Rulodonte/SISTEMA-DE-CONTROL-AMBIENTAL-MULTICAMARA/README.md

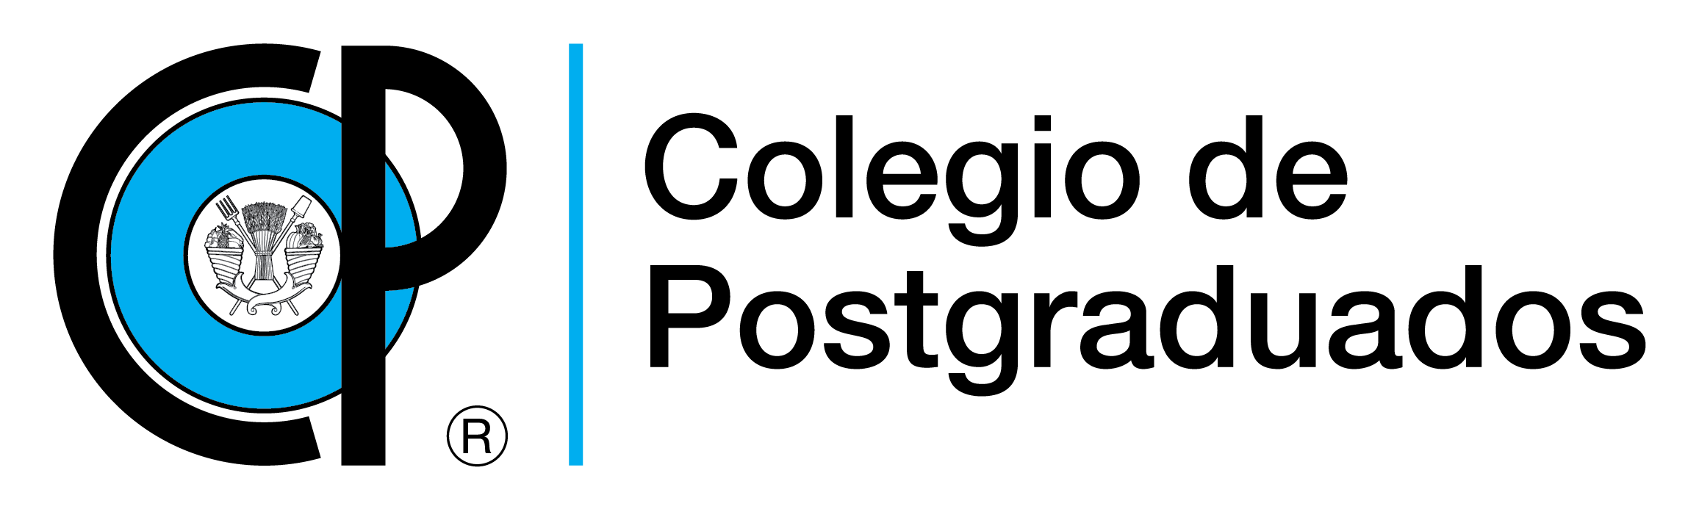
[picture p1: Imagenes_README/Logo_COLPOS.png]
Agregamos banner principal

<br><br><br><br>
# SISTEMA DE CONTROL AMBIENTAL MULTICAMARA

## Resumen
En este apartado se presentarán los anexos correspondientes al artículo titulado "Desarrollo y Evaluación de un Sistema de Control Ambiental Multicámara". 
Los anexos contienen información detallada sobre los materiales utilizados en la construcción del sistema y los componentes de los subsistemas de entrada, 
control y salida. Además, se proporciona una visión general de cómo se diseñó el sistema y se incluyen diagramas que ilustran la disposición de los 
dispositivos y el flujo de la aplicación de control.

## Contenido
- [Descripción general del sistema](#Descripción-general-del-sistema)
- [Hardware](#Hardware)
  - [Estructura](#Estructura)
  - [Dispositivos de entrada](#Dispositivos-de-entrada)
  - [Dispositivos de salida](#Dispositivos-de-salida)
  - [Dispositivos de control](#Dispositivos-de-control)
- [Software](#Software)
  - [Aplicación para Windows](#Aplicación-para-Windows)
  - [Código de control para Arduino](#Condigo-de-control-para-Arduiono)
- [Lista de materiales](#Lista-de-materiales)
- [Anexo](#Anexo)

## Descripción general del sistema
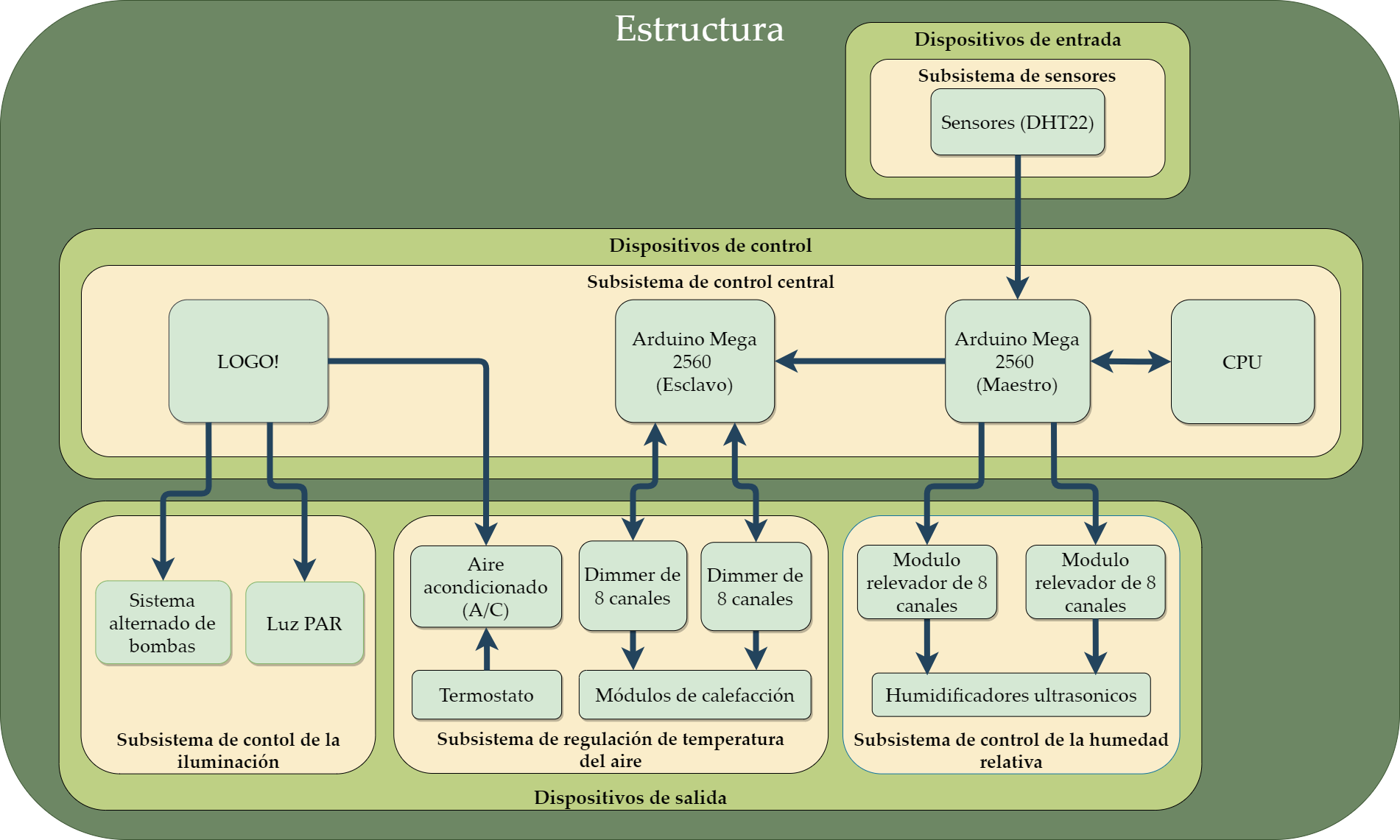
[picture p2: Imagenes_README/DiagramaHardware.png]
Agregamos diagrama de hardware

**Figura 1.** Diagrama de flujo del hardware. Interacción entre los dispositivos de entrada (subsistema de sensores), 
los dispositivos de salida (subsistema de control de la temperatura del aire, subsistema de control de la humedad 
relativa y subsistema de control de la iluminación) y los dispositivos de control (subsistema de control central). 
Todos los dispositivos están instalados en la estructura.

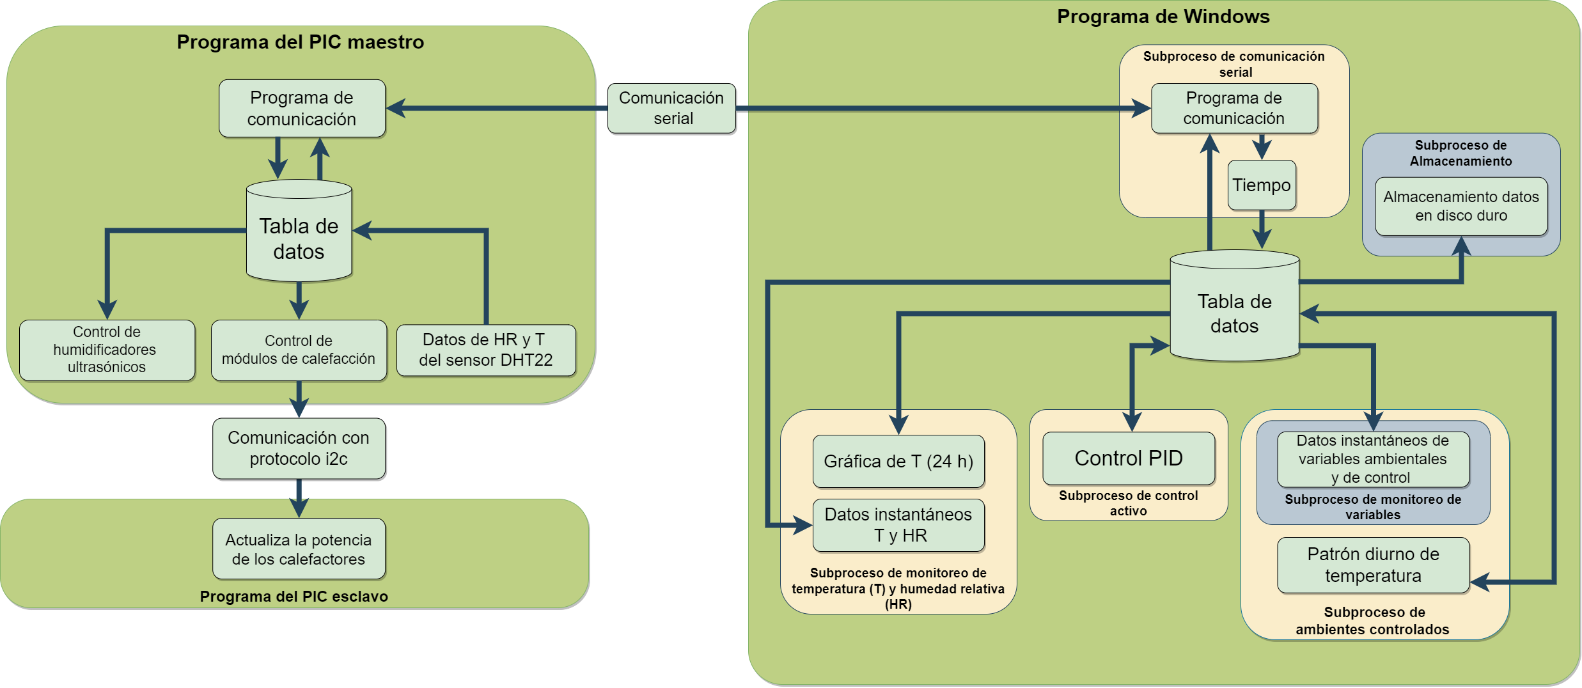
[picture p3: Imagenes_README/DiagramaSoftware.png]
Agregamos diagrama de software

**Figura 2.** Diagrama de flujo del software de control (aplicación de Windows® y PICs (maestro y esclavo) del sistema 
de control ambiental múltiple.

## Hardware

### Estructura
<p style="text-align: justify;">Consta de un armazón de angular de hierro, con dimensiones de 1.22 m de largo, 2.44 m de ancho y 0.75 m de altura. Este soporte cuenta con 15 compartimientos o cámaras de crecimiento organizadas en un arreglo matricial de 3 x 5. Cada cámara de crecimiento se delimitó con aislante térmico, formando un cubo de 0.30 m por lado (27 dm3), una vez excluido el volumen del aislante (Figura 3B).
Por otro lado, la tapa se diseñó como un prisma rectangular con dimensiones de 1.22 m de largo, 2.44 m de ancho y 0.225 m de altura. Esta tapa cumple varias funciones: Cubre y sella las cámaras de crecimiento, sirve como base para fijar el sistema de iluminación, y también actúa como la vía de salida del aire procedente de cada cámara de crecimiento (Figura 3A).</p>

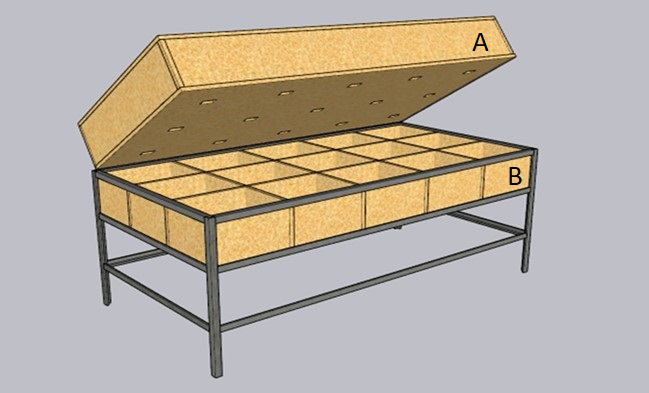
[picture p4: Imagenes_README/Estructura.png]
Estructura

<br>
**Figura 3.** Subsistema estructural. A: tapa; B: Soporte (armazón y compartimientos para las cámaras de crecimiento).

### Dispositivos de entrada
### Dispositivos de salida
**Subsistema de control de la temperatura del aire.** El subsistema encargado de regular la temperatura del aire consta de dos componentes: El módulo de enfriamiento y el módulo de calefacción. El módulo de enfriamiento se compone de un equipo de aire acondicionado (A/C) de la marca LG® con una capacidad de 12000 BTU por hora. Además, el sistema cuenta con tres extractores de la marca iPower® de 195 CFM que contribuyen al proceso de flujo del aire. Para controlar el encendido y apagado del compresor, se utilizó un módulo de termostato con pantalla de la marca Steren®.
<br>
Por otro lado, el módulo de calefacción fue construido a partir de un tubo aislante de cerá-mica de 10 cm (N° 10). Se empleó una resistencia de alambre de nicromo (34 AWG) de 170 Ω, lo que permite que el módulo funcione de 0 a 127 V, con una corriente máxima de 0.74 A (Figura 4D). La resistencia fue enrollada en un porta-resistencias (Figura 4C) también cons-truido a partir de tubo aislante de cerámica, y fijada al interior del tubo (Figura 4A) me-diante dos tornillos con tuercas (Figura 4B) que a su vez cumplen la función de pines de la resistencia. Para soportar las altas temperaturas, el tubo aislante de cerámica se adhirió con silicón térmico a un cople (1 pulgada) y una tuerca unión de PVC hidráulico de una pulgada.

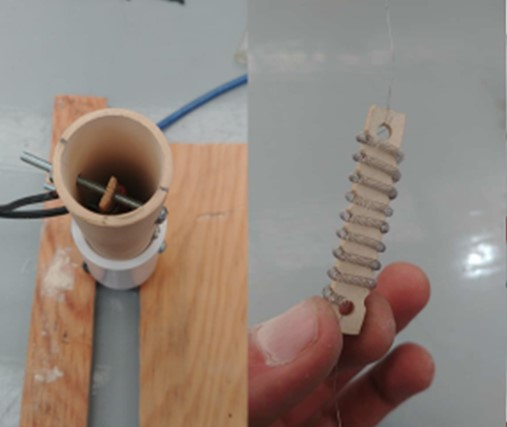
[picture p5: Imagenes_README/ModuloCalefaccion.png]
ModuloCalefaccion

<br>
**Figura 4.** Módulo de calefacción. A: Tubo aislante de cerámica; B: Tornillos de sujeción para la resistencia nicromo; C: Porta-resistencia; D: Resistencia de alambre de nicromo.

El mecanismo para el control de la temperatura se describe a continuación: El flujo de aire a 16 °C proviene del serpentín del A/C (Figura 5A) y se dirige hacia las cámaras a través de tres líneas de tubería de PVC hidráulico de 25.4 mm (1 pulgadas). Cada una de estas líneas alimenta a cinco cámaras (Figura 5B). Para regular el flujo de aire en cada línea, se emplea un extractor (Figura 5C) cuya velocidad es ajustada mediante un regulador de intensidad (“dimmer”) de la marca Leviton RNL06-10Z. El aire fluye a través de las tuberías de PVC situadas en la base de cada cámara y es conducido hacia los módulos de calefacción (Figura 5D). Estos módulos se encargan de calentar el aire hasta alcanzar la temperatura objetivo. Luego, el aire caliente es conducido hacia una salida ubicada en la parte superior de cada cámara (Figuras 5F). Por último, el aire caliente se colecta en una red de tubería de PVC de 55 mm antes de ser liberado al exterior del sistema (Figura 5G). 

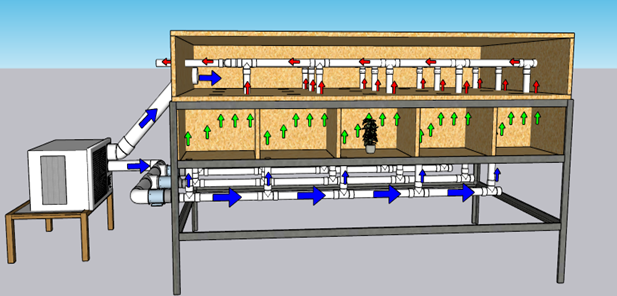
[picture p6: Imagenes_README/FlujoDeAire.png]
FlujoDeAire

<br>
**Figura 5.** Diagrama del flujo de aire para la regulación de la temperatura en las cámaras de crecimiento del subsistema de control de la temperatura del aire. A: Aire acondicionado (A/C); B: Tubería PVC para ingresar el aire a 16 °C a las cámaras de crecimiento; C: Extractores de aire; D: Módulo de calefacción; E: Orificio para la entrada de aire de las cámaras de crecimiento; F: Orificio de salida de aire de las cámaras de crecimiento; G: Red de tubería de PVC de 55 mm; H: Tubería de aire frio. Flechas azules indican flujo de aire frio. Flechas verdes indican el flujo de aire calentado por el módulo de calefacción. Flechas rojas indican el flujo de aire liberado al exterior del sistema. 

**Subsistema de control de la humedad relativa.** Para el control de la humedad relativa, se instalaron humificadores de membrana ultrasónica de 16 mm en el interior de cada cámara de crecimiento (Figura 6C). Estos microaspersores generan una brisa de microgotas de agua para aumentar y regular la humedad relativa, ya que el aire tiende a desecarse al pasar a través del evaporador del A/C. 

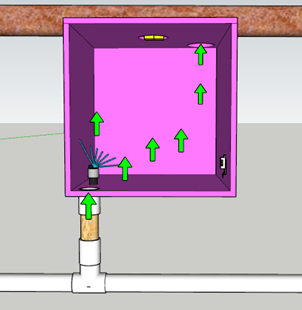
[picture p7: Imagenes_README/MicroAspersores.png]
MicroAspersores

<br>
**Figura 6.** Representación gráfica de un corte en el eje vertical de una cámara de crecimiento para mostrar los elementos responsables de regular de la humedad relativa en el subsistema de control de la humedad relativa. A: Tubería de ingreso de aire frio a la cámara de crecimiento; B: Módulo de calefacción; C: Humificador ultrasónico; D) Lámpara LED; E: Orificio de salida de aire; F: Sensor DHT22 de humedad relativa y temperatura; G: Tubería para el flujo de agua fría, encargada de absorber el calor emitido por la lámpara LED.

**Subsistema de control de la iluminación.** En cada cámara de crecimiento, se instaló un “Led Chip Full Spectrum Plant Grow Light” que emite 130 μmol s-1 m-2 de densidad de flujo de fotones fotosintéticos (DFFF) en 380 nm (luz azul) y 840 nm (luz roja). Sin embargo, debido a la emisión alta de energía calórica de estos LEDS durante su funcionamiento, se usó un método de enfriamiento basado en la recirculación de agua. La función de este arreglo es extraer por conducción el calor producido por los LEDS y mantenerlos dentro del rango de temperatura de operación. Este método de enfriamiento resulta más eficiente en comparación con la solución comercial de enfriamiento por convección forzada (mediante un ventilador) que usa un disipador térmico de aluminio unido a la parte posterior del LED, el cual incrementaría la temperatura del aire circundante a las plantas. Para el recirculamiento de agua, se usaron dos bombas periféricas de la marca Truper® de 1/2 HP que alternan su funcionamiento cada 15 min. Estas bombas hacen circular el agua a través de tubos de cobre dispuestos en tres líneas principales y alineadas de forma paralela a lo largo de la base interna del compartimiento de mezcla de aire (Figura 7A). Cada línea de tubo de cobre pasa por encima y al centro de cada cámara de crecimiento. Las tuberías de entrada y salida de agua se conectaron a un tinaco (Figura 7D). Además, para evitar un aumento significativo de temperatura generado por el calentamiento de las tuberías de cobre y la influencia de la temperatura al exterior del sistema multicámaras, se introduce aire frío al interior de la tapa, directamente del aire acondicionado (A/C) mediante una tubería de 4 pulgadas (Figuras 5H). Los LEDS se colocaron en la cara inferior de la tubería de cobre de modo que se alinearan con la parte superior central de cada cámara de crecimiento (Figura 7C). Para asegurar una correcta adhesión y transferencia de calor, se moldeó la superficie de unión con un mazo y después se pulió para facilitar la adhesión, con silicón para temperaturas altas, de cada chip de los leds a los tubos de cobre. Además, se aplicó una pasta térmica en la unión para mejorar la transmisión de calor.

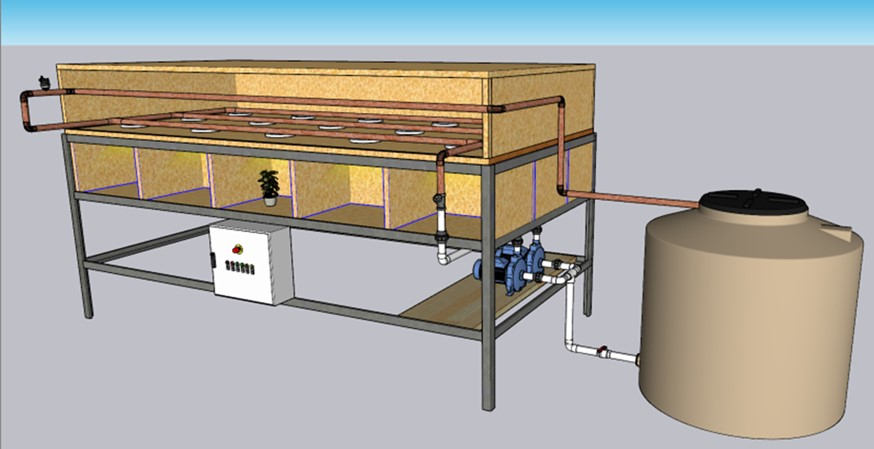
[picture p8: Imagenes_README/Iluminacion.png]
Iluminacion

<br>
**Figura 7.** Subsistema de control de la iluminación. A: Tubería de enfriamiento de los LEDS; B: Arreglo de bombas para alternar el bombeo de agua; C: Chips led adheridos a la tubería de cobre; D: Tinaco.

### Dispositivos de control
**Subsistema de control central.** La sección de control central cuenta con dos PIC: un maestro y un esclavo, ambos basados en el microcontrolador Arduino® Mega 2560 con el chip ATmega2560. Estos PIC permiten el control de los dispositivos de entrada y salida. El PIC maestro (Figura 8A) se encarga de la comunicación serial bidireccional con la computadora (CPU), recibiendo los valores de HR (%) y temperatura del aire (°C) del sensor DHT22 presente en cada cámara de crecimiento. Además, este PIC está conectado a dos módulos de relevadores mecánicos, los cuales permiten controlar el encendido de los humidificadores (Figura 9). Por otro lado, el PIC esclavo (Figura 8B) está conectado dos módulos “dimmer" de 8 canales (Figura 8C). Estos módulos permiten regular la intensidad del voltaje de corriente alterna que alimenta los módulos de calefacción. El encendido tanto del sistema de iluminación como del arreglo de bombeo alternado para el enfriamiento de los leds es gestionado por un MiniPLC (LOGO!) de Siemens© (Figura 8C).

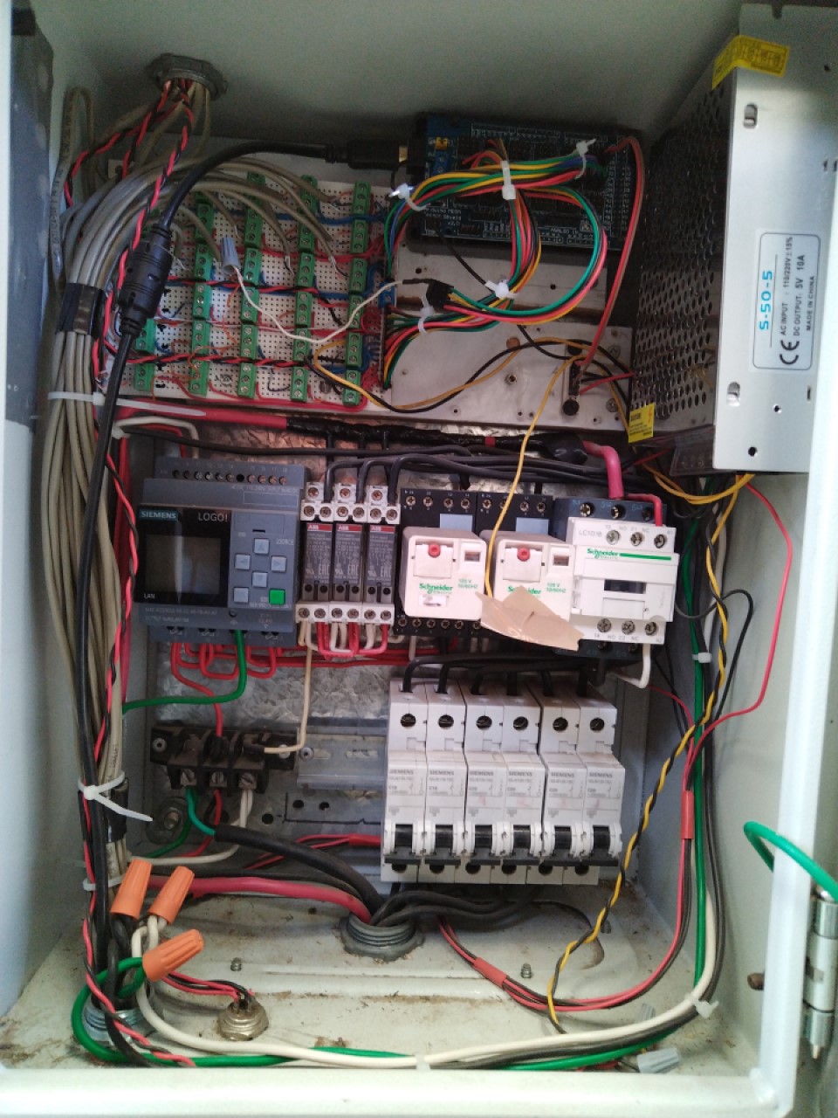
[picture p9: Imagenes_README/PICM.jpg]
 
<br>
**Figura 8.** Subsistema de control central. A: Microcontrolador maestro Arduino® Mega 2560 con el chip ATmega2560; B: Microcontrolador esclavo Arduino® Mega 2560 con el chip ATmega2560; C: Módulos “dimmer" de 8 canales; D: MiniPLC (LOGO!) de Siemens©.

## Software

### Aplicación para Windows
La aplicación de Windows esta alojada en una computadora de escritorio (CPU) y cuenta con diversas funciones. Una de ellas es establecer una comunicación serial bidi-reccional con en el PIC maestro del subsistema de control central (Figura 2). Además, la aplicación tiene la capacidad de controlar las variables ambientales, como temperatura del aire y la humedad relativa. Para lograr esto, se diseñaron dos interfases para el usuario: Una ventana para monitorear el estado de las variables ambientales y otra para el programa de control de los ambientes. (Figura 10). 
<br><br>
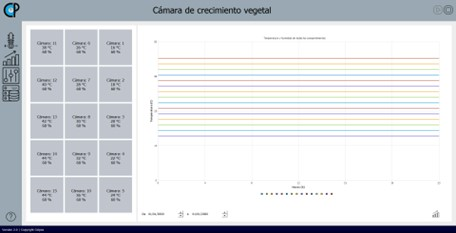
[picture p10: Imagenes_README/Monitor.jpg]
Monitor

<br>
El sistema de monitoreo y control ambiental se representa en la Figura 10, donde se muestran dos ventanas principales. En la ventana para monitorear el estado de las variables ambientales (Figura 10A), se presentan los valores actuales de humedad relativa y temperatura para cada cámara de crecimiento, junto con sus respectivos registros gráficos de las últimas 24 h. En la ventana para el programa de control de los ambientes (Figura 10B), se ofrece la opción de programar el patrón temperatura y nivel de HR para cada cámara de crecimiento. La programación de temperatura se puede realizar mediante dos opciones: mantener una temperatura constante o utilizar una curva experimental que consta de 6 puntos de ajuste.
<br><br>
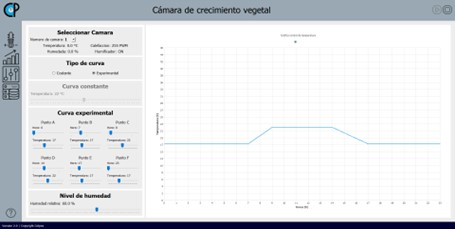
[picture p11: Imagenes_README/Control.jpg]
Control

<br>
### Código de control para Arduino
El algoritmo del PIC maestro en Arduino se encarga de la comunicación serial bidireccional con la aplicación de Windows y, además, establece la comunicación con el PIC esclavo mediante el protocolo I2C (I-cuadrado C). Su funcionalidad es recibir los valores de modulación por ancho de pulsos (PWM, 0-255) y el estado (encendido/apagado) de los humificadores ultrasónicos de cada una de las quince cámaras, los cuales son establecidos por el usuario en la aplicación de Windows. A su vez, proporciona a la aplicación los valores de temperatura (°C) y humedad relativa (%) que son medidos por los sensores DHT22, los cuales están instalados en cada una de las cámaras. Además, este algoritmo es responsable de controlar el encendido y apagado de los humificadores ultrasónicos del subsistema de control de la humedad relativa. Esto se logra mediante la gestión de dos módulos de relevadores específicos para Arduino®, los cuales actúan como interruptores de los humificadores. 
<br><br>
El algoritmo del PIC esclavo recibe los valores PWM del PIC maestro. Cada valor co-rresponde a un nivel de voltaje (0-127 V) que es regulado por medio de dos módulos dimmer de 8 canales que están conectados al PIC esclavo. Mediante el control del volta-je, se determina el nivel energía emitida por la resistencia del módulo de calefacción. 

## Lista de materiales

Cuadro 1. Materiales empleados en la construcción de la estructura.

| Nombre | Descripción | Unidades |
|---|---|---|
| Triplay De Pino | 1.22 m x 2.44 m de 16 mm de espesor | 4 piezas |
| Angulo de fierro | 3.81 cm x 3.81 cm x 0.3 cm | 28 m |
| Bisagras para puerta  | 10.16 cm x 7.89 cm | 3 piezas |
| FOAMULAR (aislante térmico) | 1.22 m x 2.44 m de 2.54 cm de espesor | 3 piezas |
<br>

Cuadro 2. Materiales empleados en la construcción de los dispositivos de entrada.
| Subsistema | Nombre | Descripción | Unidades |
|---|---|---|---|
| subsistema de sensores | Sensor de humedad y temperatura | DHT22 | 15 piezas|
<br>

Cuadro 3. Materiales empleados en la construcción de los dispositivos de control.
| Subsistema | Nombre | Descripción | Unidades |
|---|---|---|---|
| Subsistema de control central | Mini PLC | Siemens (LOGO!) | 1 pieza |
| | Arduino | Arduino Mega 2560 | 2 piezas  |
| | Fuente conmutada de alimentación  | 5v 10a 50w 110/220 V | 1 pieza |
| | PC de escritorio | Dell Inspiron | 1 pieza |
| | Módulo sensor | Shield expansion V2.0 | 1 pieza |
<br>

Cuadro 4. Materiales empleados en la construcción de los dispositivos de salida.
| Subsistema | Nombre | Descripción | Unidades |
|---|---|---|---|
| Subsistema de iluminación | Tubo de cobre | 5 cm | 10 m |
| | Reducciones tipo campana | 5 cm a 2.54 cm | 2 piezas |
| | Codos de 90° | 5 cm | 2 piezas |
| | Tee | 5 cm | 4 piezas |
| | Filtro de aire | 2.54 cm | 1 pieza  |
| | Válvula check | 2.54 cm | 1 pieza  |
| | Llave de paso | 2.54 cm | 2 piezas |
| | Tuerca unión | 2.54 cm | 2 piezas |
| | Tubo de PVC | 2.54 cm | 4 m |
| | Tuerca unión | 2.38 cm | 4 piezas |
| | Llave de paso | 2.38 cm | 2 piezas |
| | Bombas de agua | 1/2 HP | 2 piezas |
| | Led full spectro cultivo indoor | 50 w - 110 v | 15 piezas|
| | Relevadores mecánicos | 10 A | 2 piezas |
| | Interruptor electromagnético | 11 A | 2 piezas |
| Subsistema de control de la temperatura del aire | Aire acondicionado | LG 12000 BTUs | 1 pieza  |
| | Extractor de aire | iPower Ventilador (195 CFM de 10.16 mm) | 3 piezas |
| | Reducción sanitaria | 10.16 cm a 5.5 cm | 3 piezas |
| | Tee hidráulica | 55 mm | 18 piezas|
| | Codos de 90° | 55 mm | 3 piezas |
| | Tee sanitaria | 55 mm | 15 piezas|
| | Tubo PVC sanitario | 10.16 mm | 1.5 m |
| | Tee PVC sanitario | 10.16 mm | 3 piezas |
| | Cople PVC sanitario | 10.16 mm | 1 pieza  |
| | Codo 90° PVC sanitario | 10.16 mm | 1 pieza  |
| | Tubo PVC sanitario | 55 mm | 17 m |
| | Alambre de nicromo | Diámetro de 0.16mm (34 AWG) | 50 m |
| | Tubo Aislante De Cerámica Liso | 31mm (N°10) | 5 piezas |
| | Módulo dimmer de luz control potencia | Ac 8 Canales, Arduino | 2 piezas |
| | Dimmer regulador voltaje control velocidad| 110~220vac 4000w | 1 pieza  |
| | Voltímetro y amperímetro digital | 0-100 V y 0-10 A | 1 pieza  |
| Subsistema de control de la humedad relativa  | Membrana humidificadora ultrasónica | D16mm | 15 piezas|
| | Humidificador driver board | D16mm | 15 piezas|
| | Tubo CPVC | 19 mm | 10 m |
| | Codo 90° CPVC | 19 mm | 5 piezas |
| | Tee CPVC | 19 mm | 15 piezas|
| | Bomba sumergible | 200 L/h | 1 pieza  |
| | Módulo de relevadores | Relay 8 Canales 5v (Arduino) | 2 piezas |
| | Stent humidificador ultrasónico | 12 cm | 15 piezas|
| | Recipiente contenedor de agua | 2 L | 1 pieza  |
| | Llave de paso CPVC | 19 mm | 2 piezas |
| | Sensor Flotador Nivel De Agua Switch | 125-220 V y 0.5 A | 

## Anexo
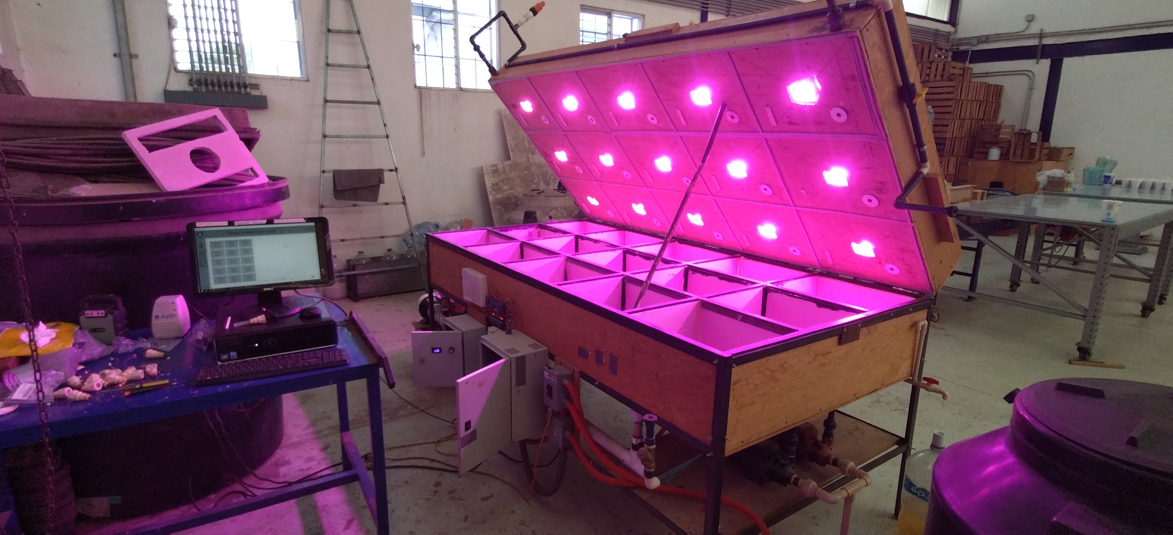
[picture p12: Imagenes_README/CamaraON.jpg]

Anexo
Anexo
Anexo
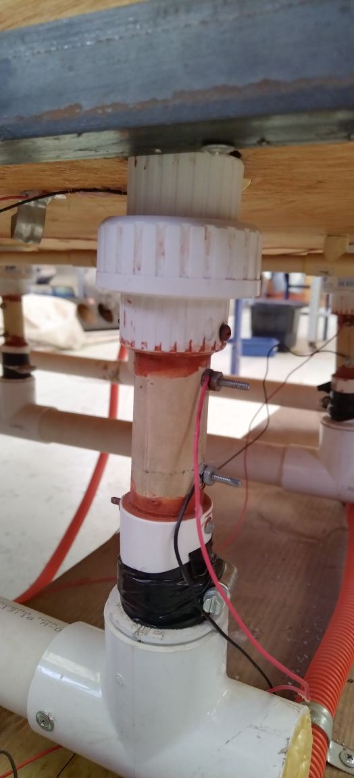
[picture p13: Imagenes_README/ModuloCalefactorCompleto.png]
