Rulodonte/SISTEMA-DE-CONTROL-AMBIENTAL-MULTICAMARA/Aplicacion (Windows)/images/arduinoSinFondo.png

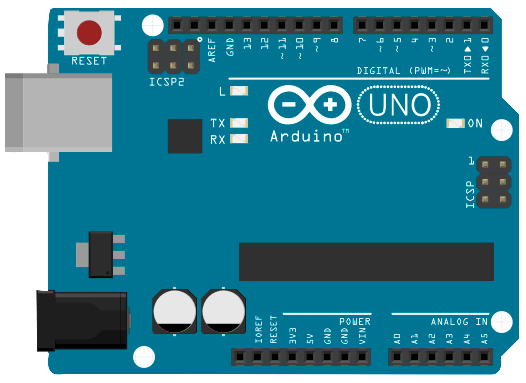
Aplicacion (Windows)/images/arduinoSinFondo.png
