Rulodonte/SISTEMA-DE-CONTROL-AMBIENTAL-MULTICAMARA/Aplicacion (Windows)/images/clima.png

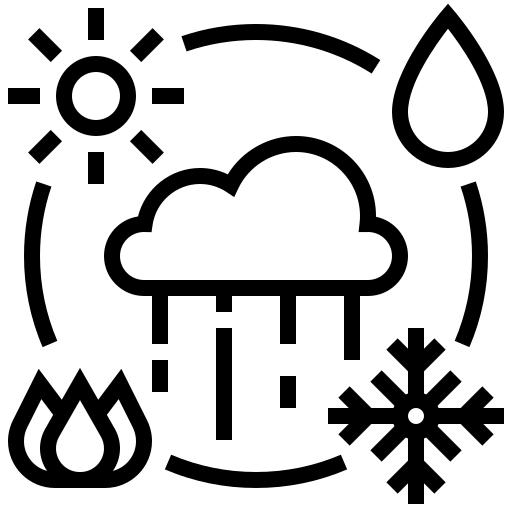
Aplicacion (Windows)/images/clima.png
