Rulodonte/SISTEMA-DE-CONTROL-AMBIENTAL-MULTICAMARA/Aplicacion (Windows)/images/temperaturas.png

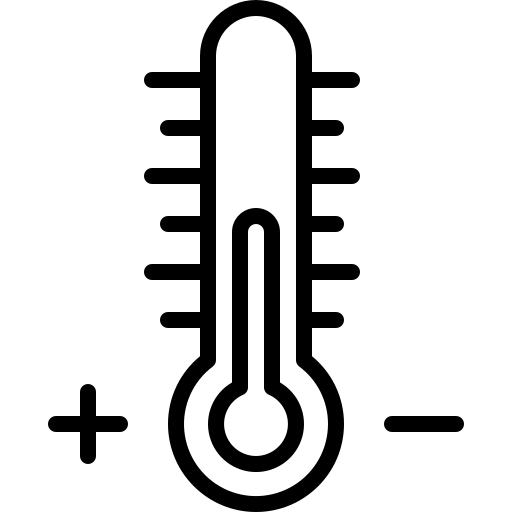
Aplicacion (Windows)/images/temperaturas.png
