Rulodonte/SISTEMA-DE-CONTROL-AMBIENTAL-MULTICAMARA/Imagenes_README/trasera.jpg

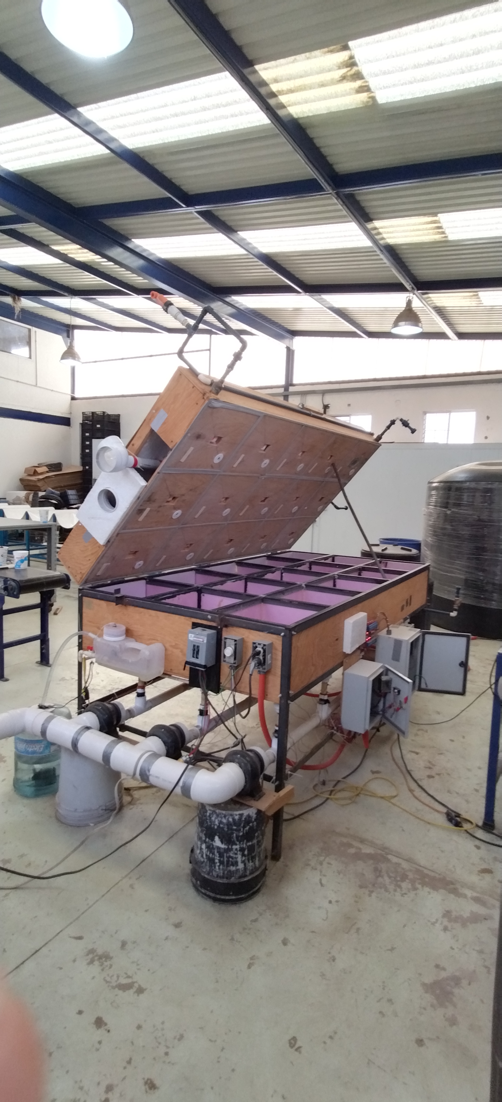
Imagenes_README/trasera.jpg
