Rulodonte/SISTEMA-DE-CONTROL-AMBIENTAL-MULTICAMARA/Aplicacion (Windows)/DataFrameTemporal.py

import pandas as pd

class TemporalDataframe:
    def __init__(self):        
        self.colnames = ["Compartimiento",
                         "Fecha", 
                         "Hora",
                         "Temperatura", 
                         "Humedad", 
                         "Humificador", 
                         "Dimmer", 
                         "Set Curva", 
                         "Tipo Control",
                         "Temperatura_Objetivo",
                         "Humedad_Relativa_Objetivo", 
                         "Parametros"]

        #este es para evaluar
        self.df = pd.DataFrame([["1","07/12/2021","11:19",  0.00, 0.00, 0, 0, "Const", "PID",  32.00, 60.0, [0, 32,   7, 32,   9, 32,   14, 32,   17, 32,   23, 32,]],
                                ["2","07/12/2021","11:19",  0.00, 0.00, 0, 0, "Const", "PID",  34.00, 60.0, [0, 34,   7, 34,   9, 34,   14, 34,   17, 34,   23, 34,]],
                                ["3","07/12/2021","11:19",  0.00, 0.00, 0, 0, "Const", "PID",  36.00, 60.0, [0, 36,   7, 36,   9, 36,   14, 36,   17, 36,   23, 36,]],
                                ["4","07/12/2021","11:19",  0.00, 0.00, 0, 0, "Const", "PID",  38.00, 60.0, [0, 38,   7, 38,   9, 38,   14, 38,   17, 38,   23, 38,]],
                                ["5","07/12/2021","11:19",  0.00, 0.00, 0, 0, "Const", "PID",  40.00, 60.0, [0, 40,   7, 40,   9, 40,   14, 40,   17, 40,   23, 40,]],
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
                                     ["15","07/12/2021","11:19",  666, 666, 0, 255, "Const", "PID", 20.00, 0.0, [0, 20,   7, 20,   9, 20,   14, 20,   17, 20,   23, 20,]]], columns = self.colnames)"""
