Rulodonte/SISTEMA-DE-CONTROL-AMBIENTAL-MULTICAMARA/(commit log)

2023-09-13 Se crea el primer archivo python "Primer Codigo"
2023-09-13 Se creo el primer cambio "Se agrego un print"
2023-09-13 Segunda modificacion "Se agrego codigo para resolver la hipotenusa"
2023-09-13 "Se agrego una imagen de Shura"
2023-09-13 Intento de agregar a shura dos
2023-09-13 Se crea carpeta de imagenes para README
2023-09-14 Se agregaron los diagramas de hardware y software
2023-09-14 Se agrego imagen de estructura
2023-09-14 Agregamos foto de modulo de calefaccion
2023-09-14 Agregamos imagen de flujo de aire
2023-09-18 Se sucio todo el codigo, pero esta versio sirve masnoes la que esta instalada enla camara
2023-10-19 FotoActualizacion
    Acualizadion de las fotos de la camara
